FelipeIot/UNIVERSAL_VMS_CONTROL/3DSHAPES/connectors/PinHeader_1x04_P2.54mm_Vertical.step

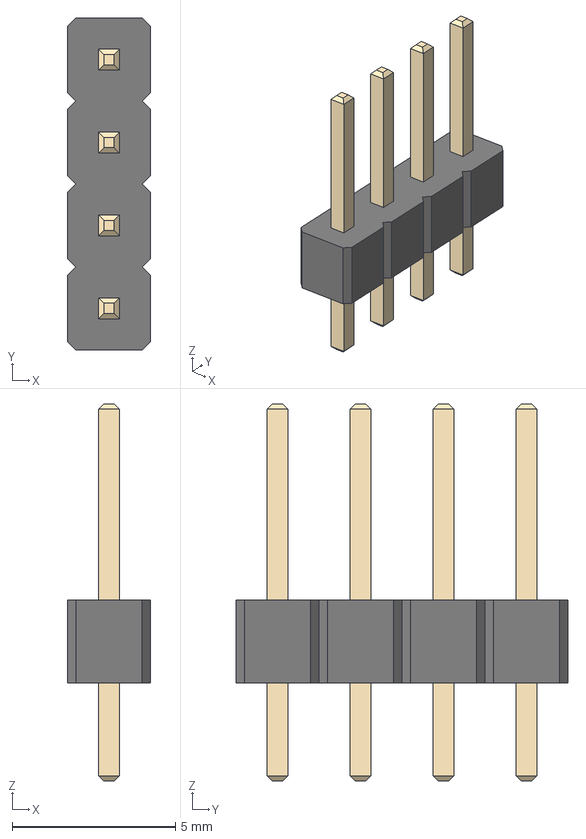
[picture p1: CAD file, 2026-09-01]
3DSHAPES/connectors/PinHeader_1x04_P2.54mm_Vertical.step
2.54 x 10.2 x 11.5 mm
