FelipeIot/UNIVERSAL_VMS_CONTROL/3DSHAPES/ics/SOT-223.step

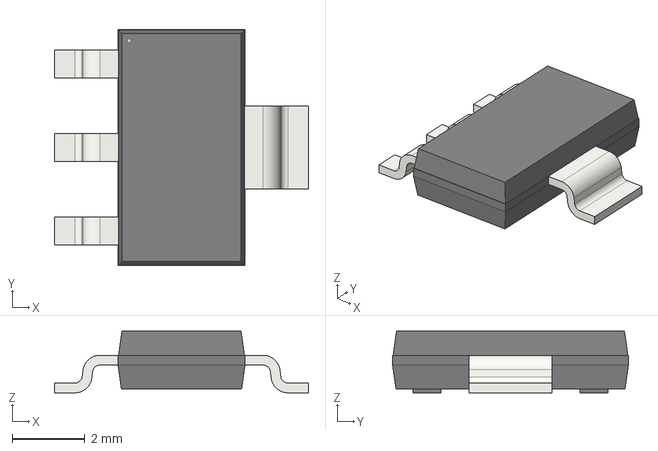
[picture p2: CAD file, 2026-09-01]
3DSHAPES/ics/SOT-223.step
7.00 x 6.50 x 1.70 mm
