FelipeIot/UNIVERSAL_VMS_CONTROL/3DSHAPES/modules/ESP32-S3-WROOM-1.step

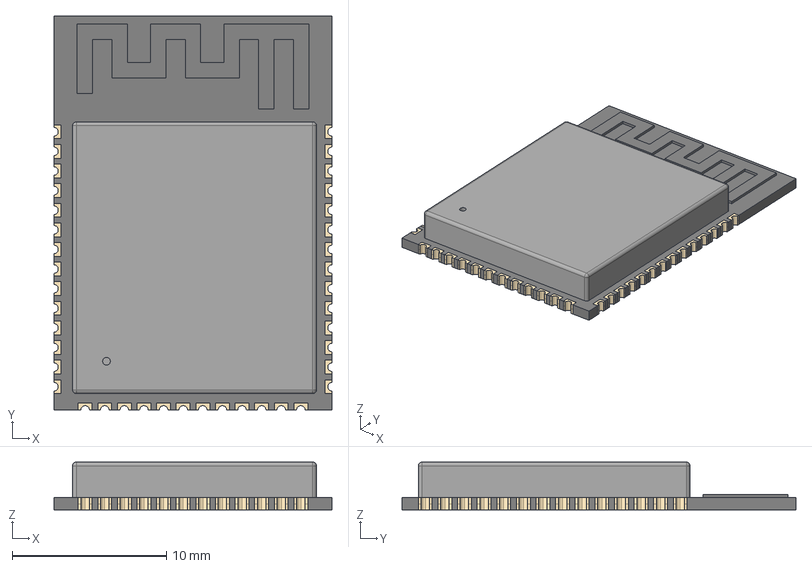
[picture p3: CAD file, 2026-09-01]
3DSHAPES/modules/ESP32-S3-WROOM-1.step
18.0 x 25.5 x 3.10 mm
