FelipeIot/UNIVERSAL_VMS_CONTROL/3DSHAPES/passives/CP_Elec_10x10.5.step

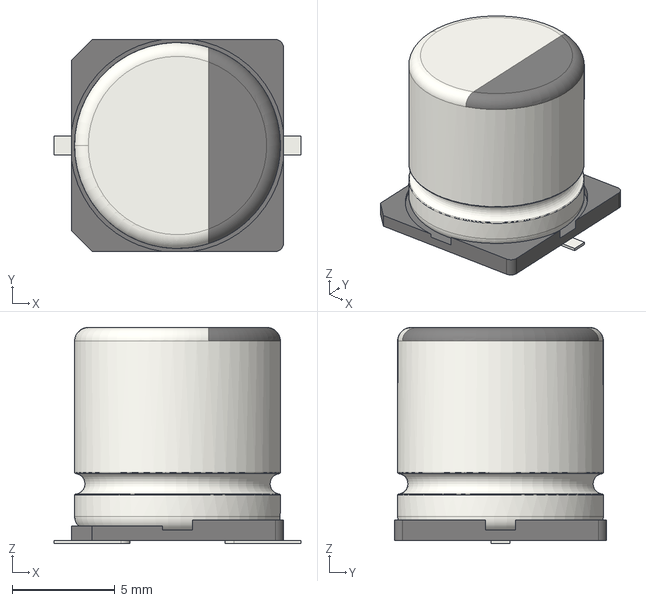
[picture p4: CAD file, 2026-09-01]
3DSHAPES/passives/CP_Elec_10x10.5.step
12.0 x 10.3 x 10.5 mm
