FelipeIot/UNIVERSAL_VMS_CONTROL/3DSHAPES/connectors/U.FL_Hirose_U.FL-R-SMT-1_Vertical.step

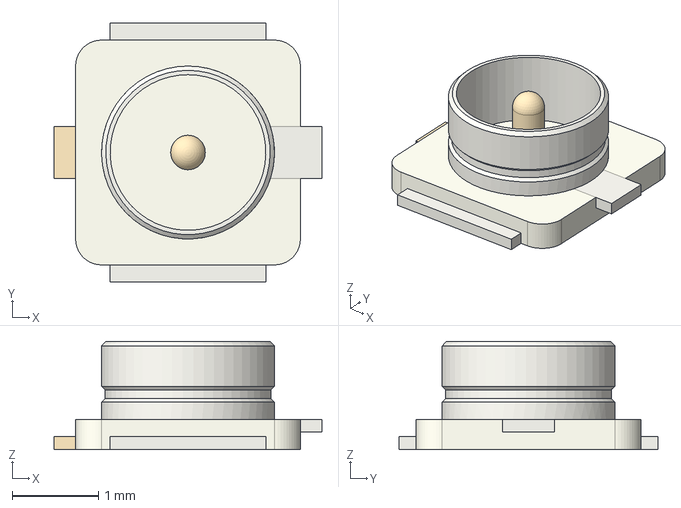
[picture p5: CAD file, 2026-09-01]
3DSHAPES/connectors/U.FL_Hirose_U.FL-R-SMT-1_Vertical.step
3.10 x 3.00 x 1.25 mm
