FelipeIot/UNIVERSAL_VMS_CONTROL/3DSHAPES/ics/SOIC-16_3.9x9.9mm_P1.27mm.step

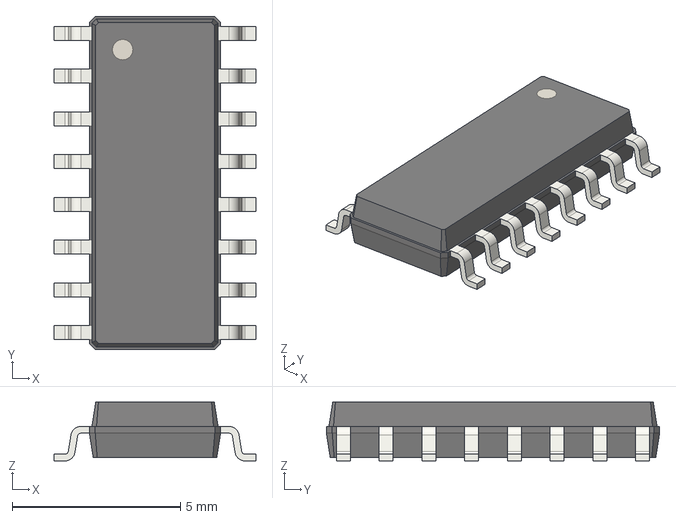
[picture p6: CAD file, 2026-09-01]
3DSHAPES/ics/SOIC-16_3.9x9.9mm_P1.27mm.step
6.00 x 9.90 x 1.75 mm
