FelipeIot/UNIVERSAL_VMS_CONTROL/3DSHAPES/passives/LED_D5.0mm.step

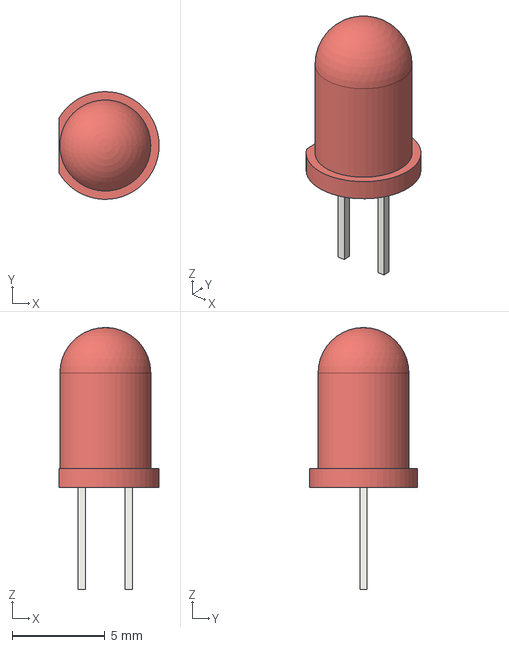
[picture p7: CAD file, 2026-09-01]
3DSHAPES/passives/LED_D5.0mm.step
5.40 x 5.79 x 14.1 mm
