FelipeIot/UNIVERSAL_VMS_CONTROL/3DSHAPES/connectors/USB_C_Receptacle_GCT_USB4085.step

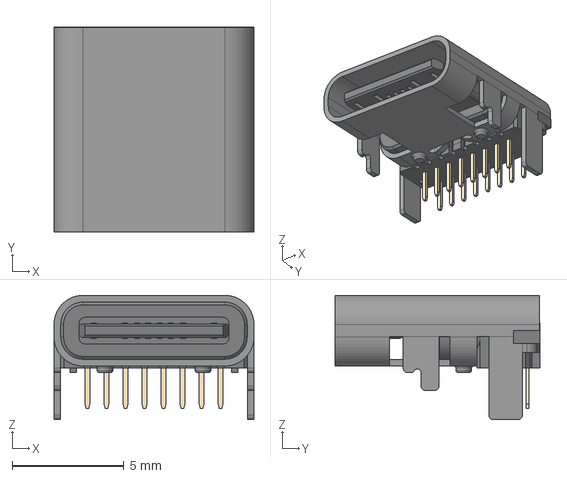
[picture p8: CAD file, 2026-09-01]
3DSHAPES/connectors/USB_C_Receptacle_GCT_USB4085.step
8.94 x 9.17 x 5.56 mm
