FelipeIot/UNIVERSAL_VMS_CONTROL/3DSHAPES/ics/TO-263-5_TabPin3.step

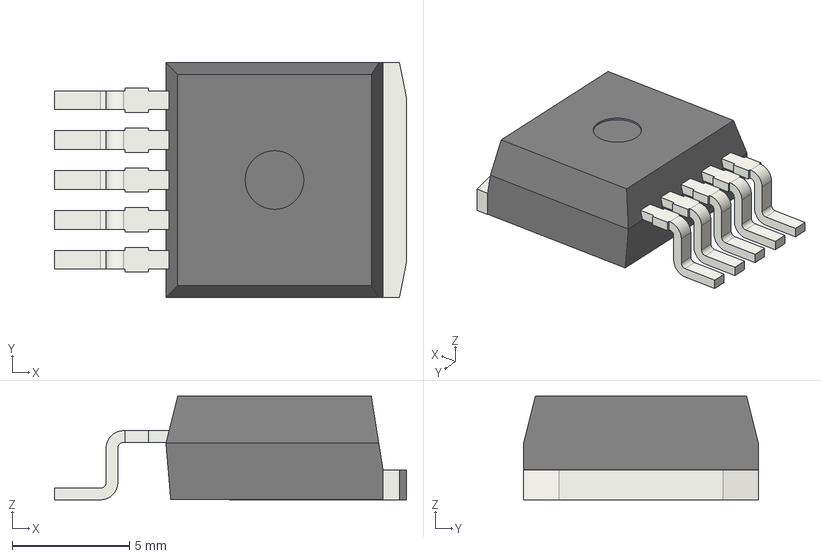
[picture p9: CAD file, 2026-09-01]
3DSHAPES/ics/TO-263-5_TabPin3.step
15.0 x 10.0 x 4.42 mm
a648ce37-9c39-11ed-93f0-dde97e994e83_part
a648ce38-9c39-11ed-93f0-dde97e994e83_part
a648ce39-9c39-11ed-93f0-dde97e994e83_part
