FelipeIot/UNIVERSAL_VMS_CONTROL/3DSHAPES/passives/SW_PUSH_6mm.step

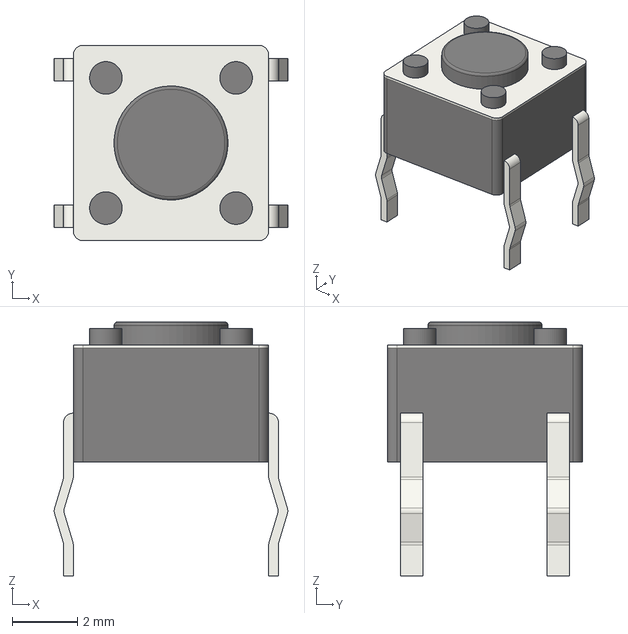
[picture p10: CAD file, 2026-09-01]
3DSHAPES/passives/SW_PUSH_6mm.step
7.17 x 6.00 x 7.80 mm
