FelipeIot/UNIVERSAL_VMS_CONTROL/3DSHAPES/connectors/DSUB-9_Pins_Horizontal_P2.77x2.84mm_EdgePinOffset9.40mm.step

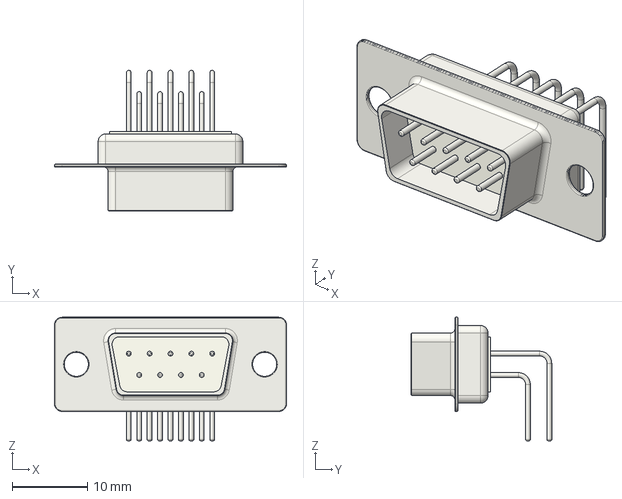
[picture p11: CAD file, 2026-09-01]
3DSHAPES/connectors/DSUB-9_Pins_Horizontal_P2.77x2.84mm_EdgePinOffset9.40mm.step
30.8 x 18.7 x 16.4 mm
