FelipeIot/UNIVERSAL_VMS_CONTROL/3DSHAPES/ics/SO8.STEP

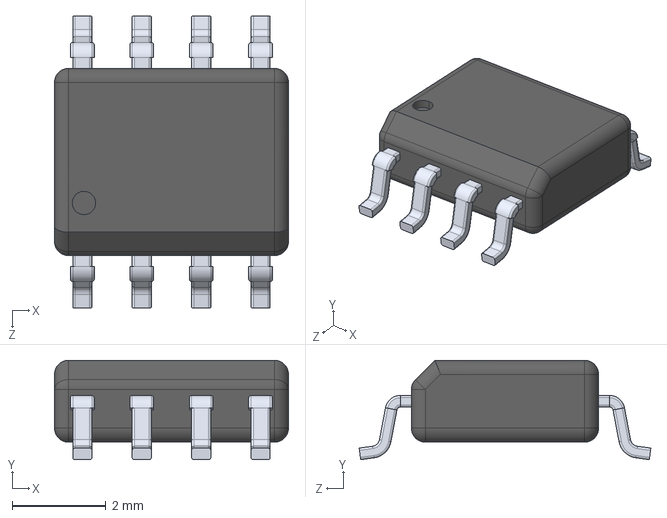
[picture p12: CAD file, 2026-09-01]
3DSHAPES/ics/SO8.STEP
5.00 x 2.12 x 6.23 mm
