FelipeIot/UNIVERSAL_VMS_CONTROL/3DSHAPES/passives/R_1206_3216Metric.step

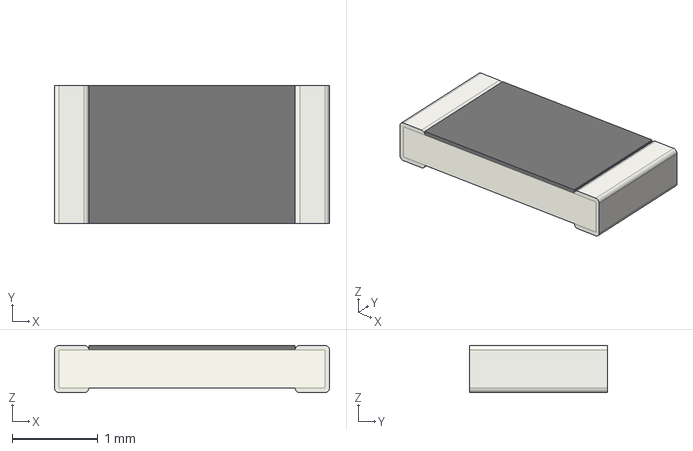
[picture p13: CAD file, 2026-09-01]
3DSHAPES/passives/R_1206_3216Metric.step
3.20 x 1.60 x 0.55 mm
