FelipeIot/UNIVERSAL_VMS_CONTROL/3DSHAPES/connectors/nanoSIM_Hinged_CUI_NSIM-2-C.step

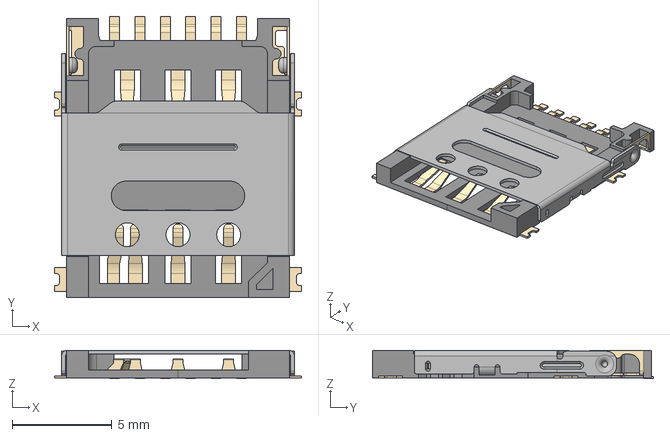
[picture p14: CAD file, 2026-09-01]
3DSHAPES/connectors/nanoSIM_Hinged_CUI_NSIM-2-C.step
12.4 x 14.1 x 1.43 mm
