FelipeIot/UNIVERSAL_VMS_CONTROL/3DSHAPES/ics/SOT-23-6.step

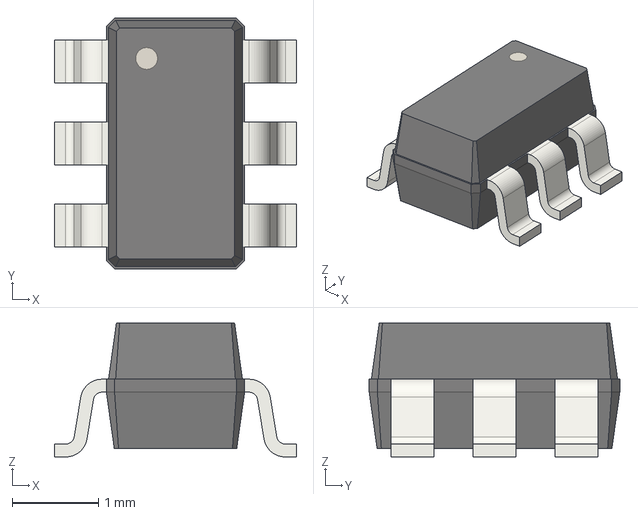
[picture p15: CAD file, 2026-09-01]
3DSHAPES/ics/SOT-23-6.step
2.80 x 2.90 x 1.55 mm
