FelipeIot/UNIVERSAL_VMS_CONTROL/3DSHAPES/passives/D_SMA.step

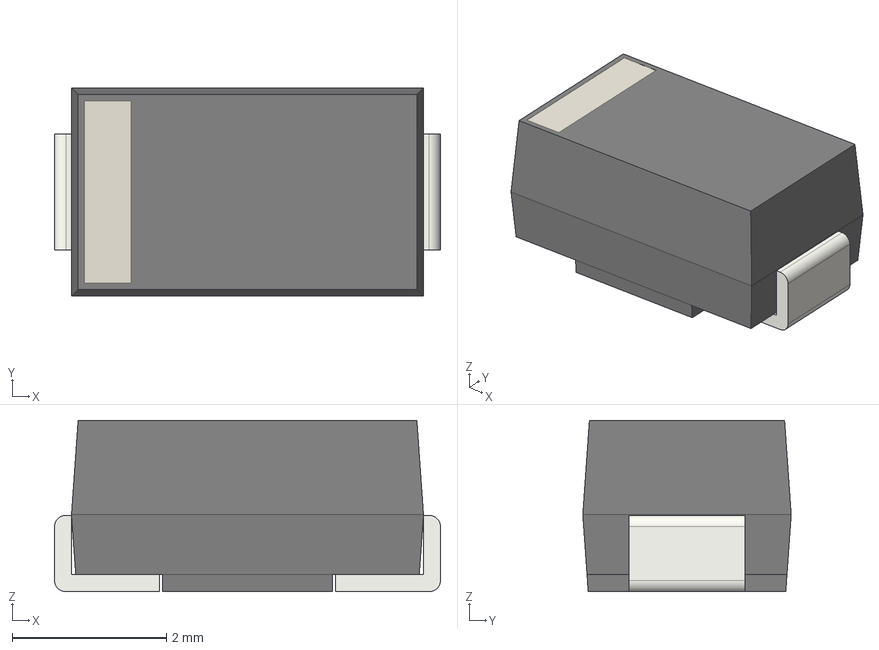
[picture p16: CAD file, 2026-09-01]
3DSHAPES/passives/D_SMA.step
5.00 x 2.70 x 2.22 mm
