FelipeIot/UNIVERSAL_VMS_CONTROL/3DSHAPES/connectors/MOLEX10POS.stp

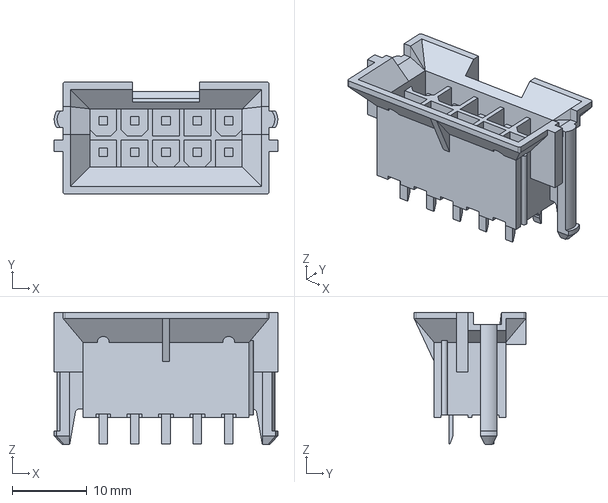
[picture p17: CAD file, 2026-09-01]
3DSHAPES/connectors/MOLEX10POS.stp
30.0 x 15.0 x 17.7 mm
