FelipeIot/UNIVERSAL_VMS_CONTROL/3DSHAPES/ics/TSSOP-24_4.4x7.8mm_P0.65mm.step

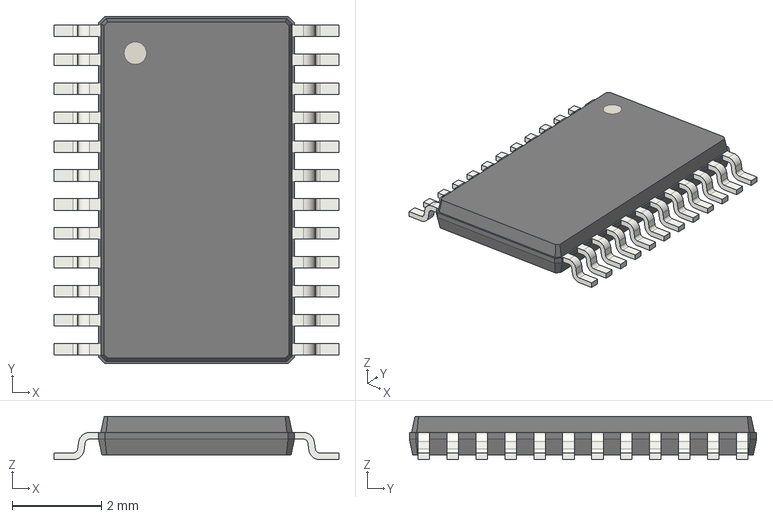
[picture p18: CAD file, 2026-09-01]
3DSHAPES/ics/TSSOP-24_4.4x7.8mm_P0.65mm.step
6.40 x 7.80 x 0.97 mm
