FelipeIot/UNIVERSAL_VMS_CONTROL/3DSHAPES/passives/D_SOD-123F.step

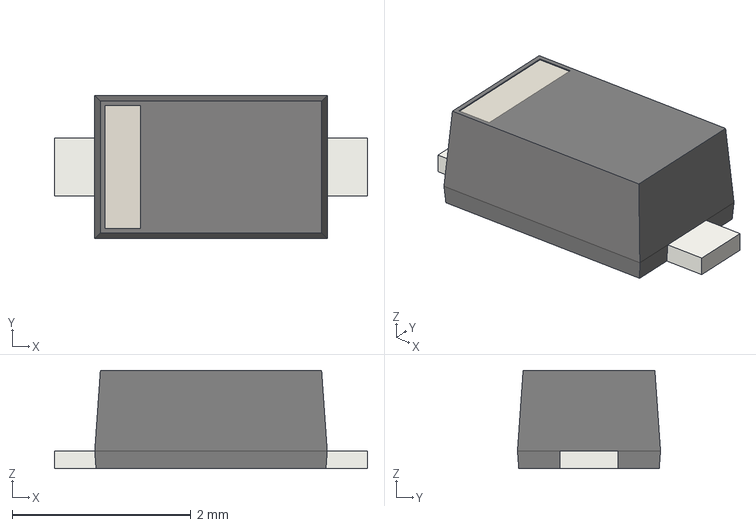
[picture p21: CAD file, 2026-09-01]
3DSHAPES/passives/D_SOD-123F.step
3.50 x 1.60 x 1.10 mm
