FelipeIot/UNIVERSAL_VMS_CONTROL/3DSHAPES/connectors/SMA_Amphenol_132134-11_Vertical.step

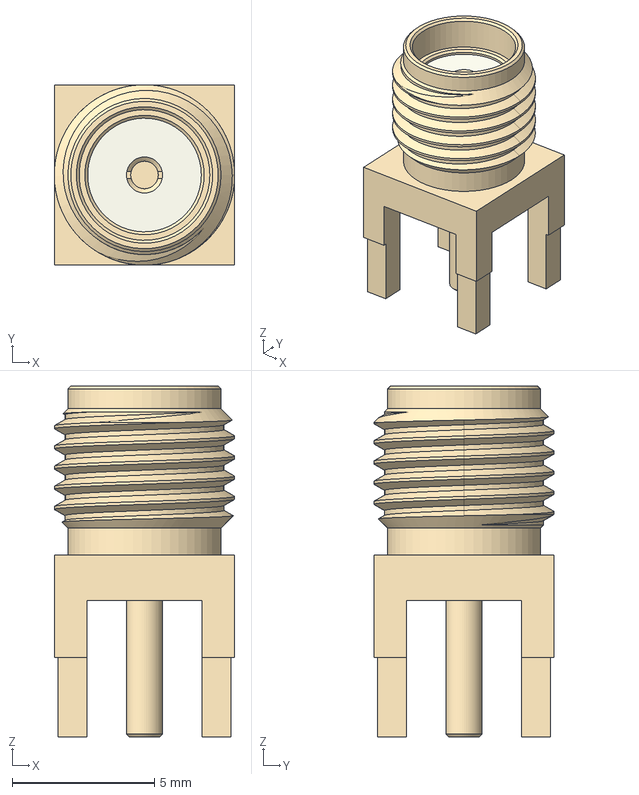
[picture p22: CAD file, 2026-09-01]
3DSHAPES/connectors/SMA_Amphenol_132134-11_Vertical.step
6.35 x 6.35 x 12.4 mm
