FelipeIot/UNIVERSAL_VMS_CONTROL/3DSHAPES/passives/D_SOD-123.step

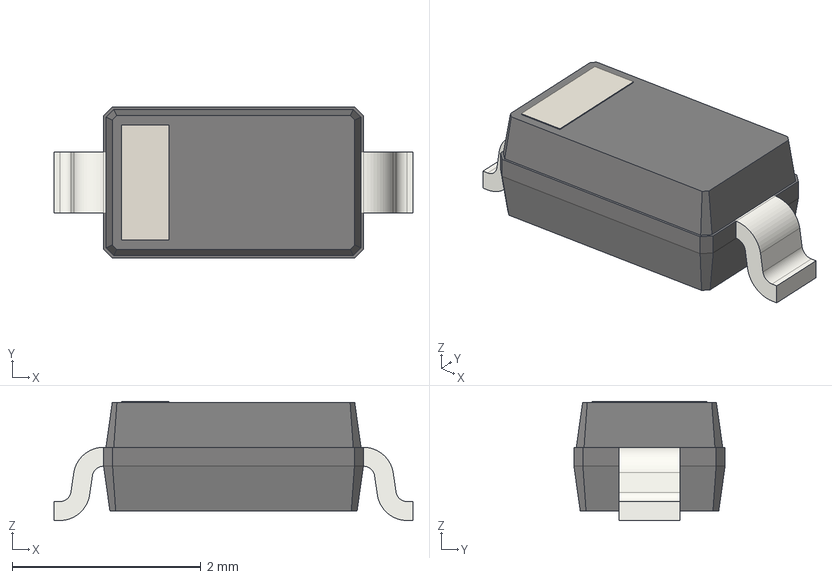
[picture p23: CAD file, 2026-09-01]
3DSHAPES/passives/D_SOD-123.step
3.80 x 1.60 x 1.26 mm
