FelipeIot/UNIVERSAL_VMS_CONTROL/3DSHAPES/connectors/DG302-5.0-02P-12-00AH.STEP

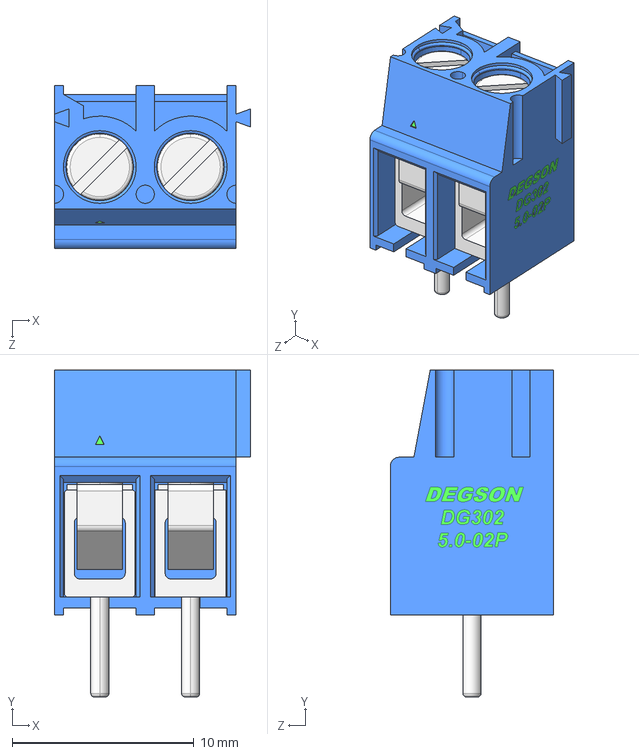
[picture p24: CAD file, 2026-09-01]
3DSHAPES/connectors/DG302-5.0-02P-12-00AH.STEP
10.8 x 18.0 x 9.00 mm
