FelipeIot/UNIVERSAL_VMS_CONTROL/3DSHAPES/passives/CP_Elec_8x10.5.step

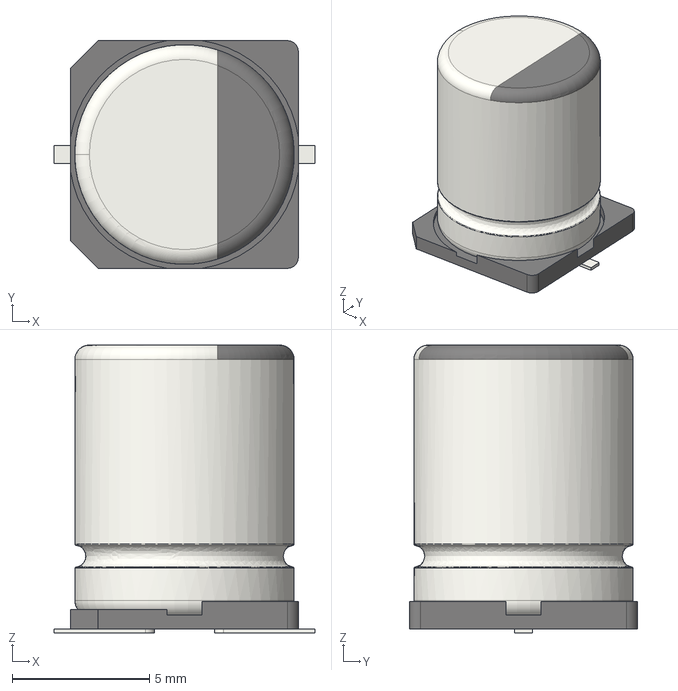
[picture p25: CAD file, 2026-09-01]
3DSHAPES/passives/CP_Elec_8x10.5.step
9.50 x 8.30 x 10.5 mm
