FelipeIot/UNIVERSAL_VMS_CONTROL/3DSHAPES/passives/C_0805_2012Metric.step

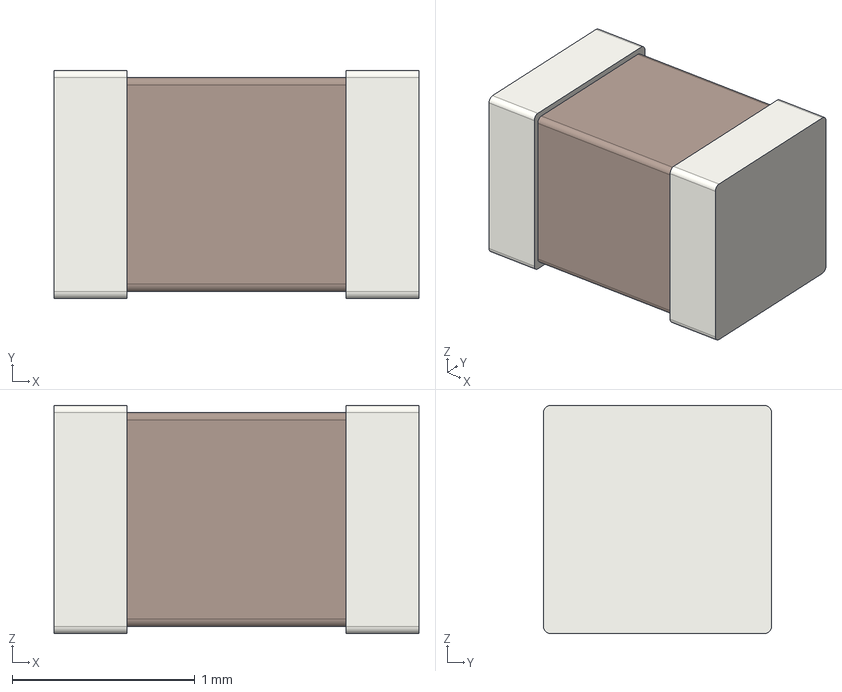
[picture p26: CAD file, 2026-09-01]
3DSHAPES/passives/C_0805_2012Metric.step
2.00 x 1.25 x 1.25 mm
