FelipeIot/UNIVERSAL_VMS_CONTROL/3DSHAPES/passives/D_2114_3652Metric.step

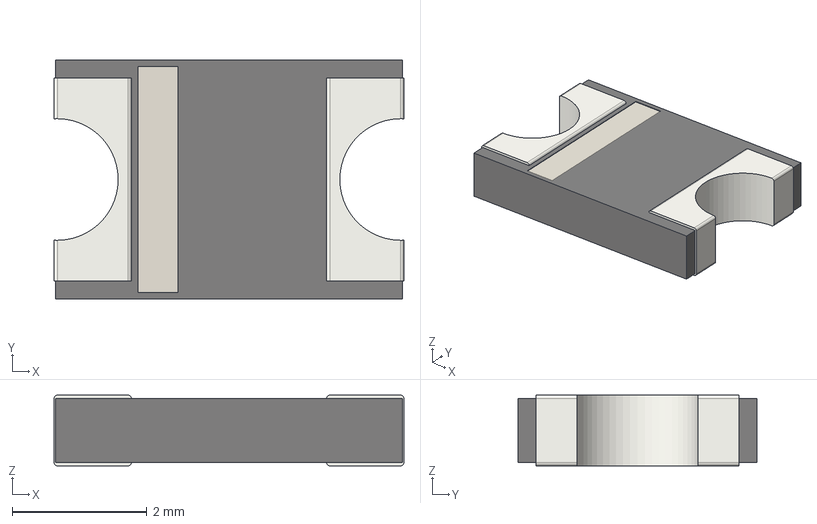
[picture p27: CAD file, 2026-09-01]
3DSHAPES/passives/D_2114_3652Metric.step
5.20 x 3.55 x 1.05 mm
