FelipeIot/UNIVERSAL_VMS_CONTROL/3DSHAPES/passives/L_Bourns_SDR1806.step

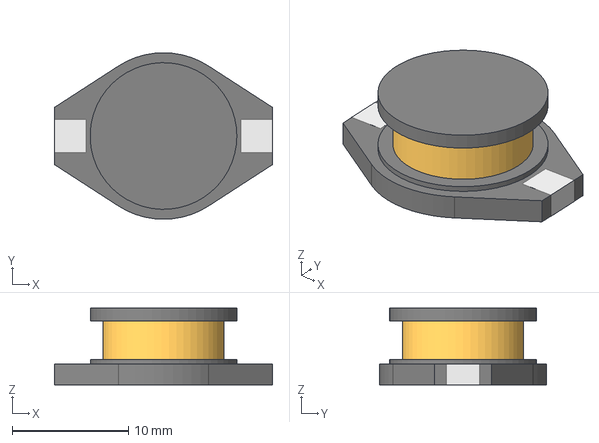
[picture p28: CAD file, 2026-09-01]
3DSHAPES/passives/L_Bourns_SDR1806.step
18.7 x 14.3 x 6.61 mm
