FelipeIot/UNIVERSAL_VMS_CONTROL/(list of files, cad)

Other CAD files:
3DSHAPES/power/0679L5000-05.step
