FelipeIot/UNIVERSAL_VMS_CONTROL/controlcarreta.kicad_pcb

## KiCad design controlcarreta.kicad_pcb (2026-09-02)

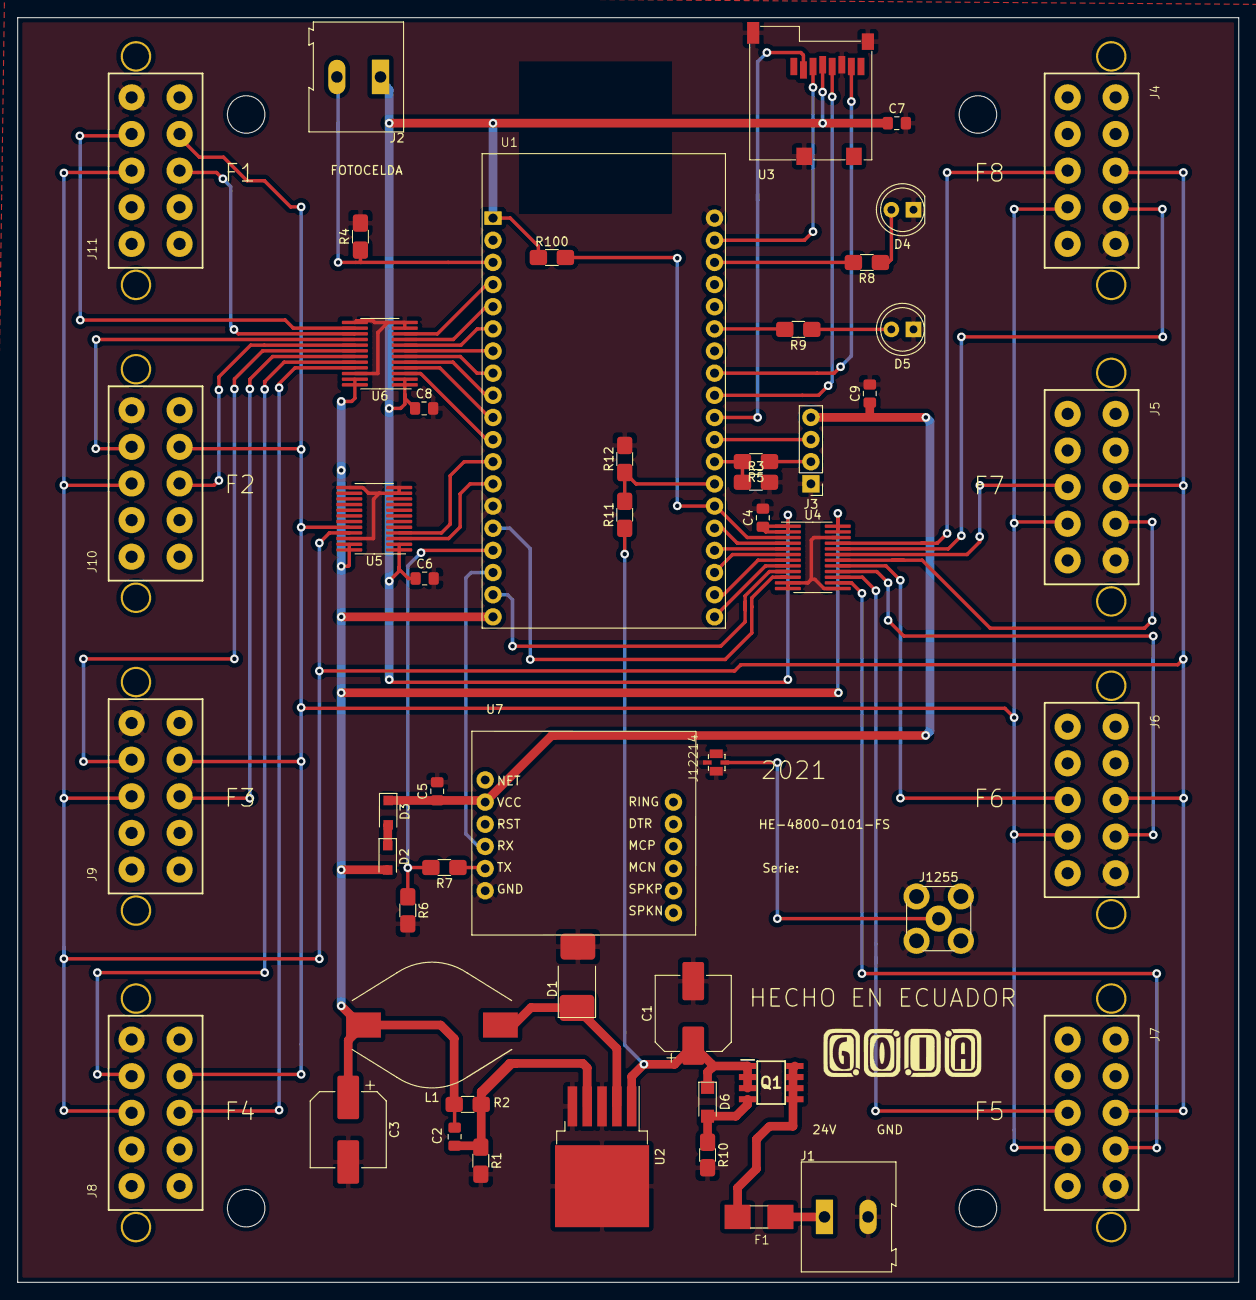
[picture p29: board controlcarreta.kicad_pcb from above]

Board: 2 copper layers, 140.0 x 145.0 mm, 55 parts (0 on the bottom side), 64 nets.

Parts:
C1, C3: CP; CP_Elec_8x10.5
C2: CAP; C_0805_2012Metric_Pad1.18x1.45mm_HandSolder
C4, C5, C6, C7, C8, C9: C; C_0805_2012Metric_Pad1.18x1.45mm_HandSolder
D1: D_Zener; D_2114_3652Metric
D2, D3: 1N4007; D_SOD-123F
D4, D5: LED; LED_D5.0mm
D6: D_Zener; D_SOD-123
F1: 0679L5000-05; FUSC6125X279N
H1, H2, H3, H4: MountingHole; MountingHole_4.3mm_M4
J1, J2: Screw_Terminal_01x02; TerminalBlock_Altech_AK300-2_P5.00mm
J3: Conn_01x04_Male; PinHeader_1x04_P2.54mm_Vertical
J4, J5, J6, J7, J8, J9, J10, J11: MOLEX10POS
J1255: Conn_Coaxial; SMA_Amphenol_132134-16_Vertical
J12214: RSP-122811-02; SAMTEC_RSP-122811-02
L1: INDUCTOR; L_Bourns_SDR1806
Q1: SI4447ADY-T1-GE3; SOIC127P600X175-8N
R1, R12: 1k; R_1206_3216Metric_Pad1.30x1.75mm_HandSolder
R2: 3k; R_1206_3216Metric_Pad1.30x1.75mm_HandSolder
R3, R4, R6: 10k; R_1206_3216Metric_Pad1.30x1.75mm_HandSolder
R5, R7: 1.5k; R_1206_3216Metric_Pad1.30x1.75mm_HandSolder
R8, R9: 330 ohm; R_1206_3216Metric_Pad1.30x1.75mm_HandSolder
R10: 100K; R_1206_3216Metric
R11: 22k; R_1206_3216Metric_Pad1.30x1.75mm_HandSolder
R100: R; R_1206_3216Metric_Pad1.30x1.75mm_HandSolder
U1: ESP32-DEVKITC-32D; MODULE_ESP32-DEVKITC-32D
U2: LM2596S-ADJ; TO-263-5_TabPin3
U3: sdcard; sdcardgoia
U4, U5, U6: 74LVC8T245PW; TSSOP-24_4.4x7.8mm_P0.65mm
U7: sim800l

Connections:
+3V3: C4.1, C6.1, C7.1, C8.1, J2.1, R100.1, U1.1, U3.4, U4.1, U4.2, U5.1, U5.2, U6.1, U6.2
+3V8: C5.1, C9.1, D3.1, J3.4, U7.2
+5V: C2.1, C3.1, D2.2, L1.2, R2.1, U1.19, U4.23, U4.24, U5.23, U5.24, U6.23, U6.24
+24V: C1.1, D6.1, Q1.1, Q1.2, Q1.3, R11.1, U2.1
/BRILLO: U1.13, U5.3
/CL: U1.12, U5.4
/CLOCK: J4.03, J5.03, J6.03, J7.03, J8.03, J9.03, J10.03, J11.03, U5.20
/D1: U1.34, U4.4
/D2: U1.36, U4.6
/D3: U1.38, U4.8
/D4: U1.15, U4.10
/D5: U1.10, U6.4
/D6: U1.8, U6.6
/D7: U1.6, U6.8
/D8: U1.4, U6.10
/DIM: J4.06, J5.06, J6.06, J7.06, J8.06, J9.06, J10.06, J11.06, U5.21
/FOTO: J2.2, R4.1, U1.3
/LE1: R100.2, U1.33, U4.3
/LE2: U1.35, U4.5
/LE3: U1.37, U4.7
/LE4: U1.18, U4.9
/LE5: U1.11, U6.3
/LE6: U1.9, U6.5
/LE7: U1.7, U6.7
/LE8: U1.5, U6.9
/LEN1: J4.05, U4.21
/LEN2: J5.05, U4.19
/LEN3: J6.05, U4.17
/LEN4: J7.05, U4.15
/LEN5: J8.05, U6.21
/LEN6: J9.05, U6.19
/LEN7: J10.05, U6.17
/LEN8: J11.05, U6.15
/MISO: U1.27, U3.7
/MOSI: U1.21, U3.3
/RX_GPS: J3.3, U1.30
/RX_SIM: U1.17, U7.4
/SCK: U1.28, U3.5
/SIN1: J4.04, U4.20
/SIN2: J5.04, U4.18
/SIN3: J6.04, U4.16
/SIN4: J7.04, U4.14
/SIN5: J8.04, U6.20
/SIN6: J9.04, U6.18
/SIN7: J10.04, U6.16
/SIN8: J11.04, U6.14
/SS: U1.29, U3.2
/TX_GPS: R3.1, R5.2, U1.31
/TX_SIM: R6.1, R7.2, U1.16
/VREAD: R11.2, R12.1, U1.32
GND: C1.2, C3.2, C4.2, C5.2, C6.2, C7.2, C8.2, C9.2, D1.2, D4.1, D5.1, J1.2, J3.1, J4.02, J5.02, J6.02, J7.02, J8.02, J9.02, J10.02, J11.02, J1255.2, J1255.3, J12214.2, J12214.3, J12214.4, R1.2, R3.2, R4.2, R6.2, R10.2, R12.2, U1.14, U1.20, U2.3, U2.5, U3.6, U3.9, U4.11, U4.12, U4.13, U4.22, U5.11, U5.12, U5.13, U5.22, U6.11, U6.12, U6.13, U6.22, U7.6
unnamed: C2.2, R1.1, R2.2, U2.4
unnamed: D1.1, L1.1, U2.2
unnamed: D2.1, D3.2
unnamed: D4.2, R8.1
unnamed: D5.2, R9.1
unnamed: D6.2, Q1.4, R10.1
unnamed: F1.1, J1.1
unnamed: F1.2, Q1.5, Q1.6, Q1.7, Q1.8
unnamed: J3.2, R5.1
unnamed: J1255.1, J12214.1
unnamed: R7.1, U7.5
unnamed: R8.2, U1.22
unnamed: R9.2, U1.25
