FelipeIot/UNIVERSAL_VMS_CONTROL/(commit log)

2026-09-01 Initial commit: proyecto Control Carreta IoT (migrado a ESP32-S3)
    Estado del esquematico (controlcarreta.kicad_sch, KiCad 9):
    - MCU: modulo SMD ESP32-S3-WROOM-1-N8 (antes placa ESP32-DevKitC-32D)
    + circuiteria de soporte (LDO 3V3, EN/BOOT, USB-C nativo, ESD).
    - Modem celular: zocalo Mini PCIe (J14, EG25-G / SIM7600G-H) + buck
    dedicado 24V->3V3/3A, porta nano-SIM, u.FL; antena SMA J1255 conservada.
    Sustituye al SIM800L.
    - Puerto RS-232 para equipo externo: MAX3232 (U11) + DE9 (J17) en GPIO43/44.
    - Se elimino el panel de LED nº 8 (J11) para liberar GPIO.
    - Campo Datasheet de los 87 componentes reales con link de DigiKey.
    - ERC: 0 errores.
    Anadido:
    - 3d_models/ modelos 3D de todos los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
    [0679L5000-05.step, CP_Elec_8x10.5.step, C_0805_2012Metric.step, DG302-5.0-02P-12-00AH.STEP, DSUB-9_Pins_Horizontal_P2.77x2.84mm_EdgePinOffset9.40mm.step, D_2114_3652Metric.step, D_SMA.step, D_SOD-123.step]
2026-09-01 J14: zocalo Mini PCIe con footprint/simbolo estandar de KiCad
    - Simbolo: Connector:Bus_PCI_Express_Mini (antes: simbolo propio MINI_PCIE_52,
    inventado).
    - Footprint: Connector_PCBEdge:BUS_PCI_Express_Mini_Full (zocalo Mini PCIe 52p
    real; antes un nombre inventado que no existia).
    - H5 -> Connector_PCBEdge:JAE_MM60-EZH039-Bx_BUS_PCI_Express_Holder (retencion).
    - R27 (0 ohm) nuevo: pin 23 (UART_CTS del modem) -> GND. El pin es tipo
    'output' en el simbolo estandar, atarlo directo a GND daba error ERC.
    - MINI_PCIE_52 eliminado de controlcarreta.kicad_sym.
    - El cableado se mantiene por numero de pin (mapa en ESP32-S3-MIGRATION.md).
    - collect_3d.py: ahora lee los footprints del esquematico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
    [CP_Elec_10x10.5.step, controlcarreta.kicad_sch]
2026-09-01 U4/U5/U6: 74LVC8T245PW -> version AEC-Q100 (grado automocion)
    MPN/Value = 74LVC8T245PW-Q100J (Nexperia). Mismo chip, mismo footprint
    TSSOP-24, drop-in; solo cambia el grado a AEC-Q100 (-40..+125 C), apropiado
    para el uso en vehiculo. Anadidos campos MPN y MANUFACTURER, y Datasheet
    apunta a la pagina de DigiKey del -Q100J.
    Netlist identico (cambio solo de propiedades). ERC 0 errores.
    Claude-Session: https://claude.ai/code/session_011V2GTHvqBgNdus4vsEVVnA
    [controlcarreta.kicad_sch]
2026-09-01 Esquematico: reorganizacion del layout (subsistemas nuevos sin solapes)
    Reconstruye la disposicion de los ~40 componentes anadidos en la migracion
    a ESP32-S3 (buck del modem, zocalo Mini PCIe J14, USB-C, RS-232) con un
    floor plan por zonas. J14 vuelve a caer dentro de la hoja A3.
    - Conectividad identica al commit anterior: el netlist coincide pin a pin,
    solo cambian posiciones.
    - J14 +3V3AUX a un unico riel/simbolo; GND y MP consolidados.
    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
    [controlcarreta.kicad_sch]
2026-09-01 J14: zocalo real JAE MM60-52B1-E1-R650 (en stock) en vez del modulo Quectel
    El campo MPN/Datasheet de J14 apuntaba al modulo Quectel EG25GGB-MINIPCIE,
    que no tiene stock. J14 es el ZOCALO Mini PCIe, no el modulo:
    - MPN -> JAE MM60-52B1-E1-R650 (DigiKey Active, ~28k stock, ~1,65 US$),
    socket 52p 0,8mm con eyectores/latch integrados.
    - Value -> "Mini PCIe Socket 52p". La tarjeta EG25-G/SIM7600G-H se inserta,
    no va en BOM (campo "Modulo" informativo).
    - H5 eliminado: el MM60-E1 ya trae la retencion, no hace falta holder aparte.
    - Footprint sin cambios (BUS_PCI_Express_Mini_Full = socket "with clips").
    - Conectividad y ERC sin cambios (0 errores).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
    [controlcarreta.kicad_sch]
2026-09-01 U11: MAX3232IDR (obsoleto) -> MAX3232EIDR ; limpieza de MPNs sin stock
    - U11: el MAX3232IDR esta "Obsolete and no longer manufactured". Cambiado al
    drop-in MAX3232EIDR (TI, Active, ~55k stock, mismo SOIC-16 y pinout, +-15kV ESD).
    - U9: datasheet apuntaba a un clon Slkormicro; ahora al USBLC6-2SC6 de ST
    (Active, ~294k stock). Mismo MPN/footprint.
    - J15: URL actualizada al listado vigente (CUI -> Same Sky), parte NSIM-2-C Active.
    - Verificado el resto de piezas nuevas: LM2596S-ADJ/NOPB, NCP1117ST33T3G,
    USB4085-GF-A, JAE MM60-52B1-E1-R650 -> todas Active y con stock.
    - Sin cambios de conectividad ni de ERC (0 errores).
    Claude-Sessio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
    [controlcarreta.kicad_sch]
2026-09-02 home parcial ordered
    [0679L5000-05.step, CP_Elec_10x10.5.step, CP_Elec_8x10.5.step, C_0805_2012Metric.step, DG302-5.0-02P-12-00AH.STEP, DSUB-9_Pins_Horizontal_P2.77x2.84mm_EdgePinOffset9.40mm.step, D_2114_3652Metric.step, D_SMA.step]
2026-09-02 WIP: J18/Q2/Q3/R30/R31 + reguardado KiCad de todas las hojas
    [controlcarreta.kicad_sch, drivers.kicad_sch, ldo_3v3.kicad_sch, modem.kicad_sch, psu_5v.kicad_sch, psu_modem.kicad_sch, rs232.kicad_sch, sdcard.kicad_sch]
2026-09-02 modem: DTR (J14 pin 31) fuera de GND -> GPIO IO3 (net MODEM_DTR)
    El EG25-G/SIM7600 no puede entrar en sleep con DTR a masa (idle ~20 mA
    en vez de ~4 mA). Se suelta el pin 31 de GND y se lleva a U1 IO3
    (GPIO libre, antes NO_CONNECT) via nueva senal jerarquica MODEM_DTR:
    - modem.kicad_sch: #PWR0551 (GND) -> hierarchical_label MODEM_DTR
    - controlcarreta.kicad_sch: pin de hoja MODEM_DTR + label en U1.15 (IO3),
    se elimina el no_connect de IO3
    ERC sin cambios (370 warnings, 0 errores). Panel LED 7 se conserva:
    habia 3 GPIO libres (IO3/IO45/IO46), no hacia falta sacrificarlo.
    Claude-Session: https://claude.ai/code/session_01T7LXaJdHR17h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
    [controlcarreta.kicad_sch, modem.kicad_sch]
2026-09-02 modem: 2a via de antena ANT_GNSS (J19 u.FL + J20 SMA) para GPS
    El EG25-G / SIM7600 llevan receptor GNSS integrado pero necesitan
    antena propia; el esquematico solo tenia ANT_MAIN. Se anade una 2a via
    RF identica en topologia a ANT_MAIN:
    - modem.kicad_sch: J19 (u.FL Hirose) -> hierarchical_label ANT_GNSS,
    blindaje a GND (#PWR0563). Pigtail u.FL-u.FL a la toma GNSS de la
    tarjeta Mini-PCIe.
    - controlcarreta.kicad_sch: pin de hoja ANT_GNSS + J20 (SMA Amphenol)
    en la net ANT_GNSS, blindaje a GND (#PWR0564). Caja de la hoja MODEM
    ampliada (12.7 -> 17.78 mm) para alojar los 2 pines nuevos.
    - Poblar J19 O J20 (no ambos). Antena GNSS pasiva, vista al cielo,
    >=3 cm de ANT_MAIN.
    ERC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
    [controlcarreta.kicad_sch, modem.kicad_sch]
2026-09-04 friday changes
    [controlcarreta.kicad_sch, drivers.kicad_sch, ldo_3v3.kicad_sch, modem.kicad_sch, psu_5v.kicad_sch, psu_modem.kicad_sch, rs232.kicad_sch, sdcard.kicad_sch]
2026-09-08 schematic updated
    [controlcarreta.kicad_sch, drivers.kicad_sch, ldo_3v3.kicad_sch, modem.kicad_sch, psu_5v.kicad_sch, psu_modem.kicad_sch, rs232.kicad_sch, sdcard.kicad_sch]
2026-09-08 removed gps headear
    [controlcarreta.kicad_sch, ldo_3v3.kicad_sch]
2026-09-08 prettier schematic
    [controlcarreta.kicad_sch, mechanical.kicad_sch, sdcard.kicad_sch]
2026-09-09 2 power source
    [controlcarreta.kicad_sch, drivers.kicad_sch, ldo_3v3.kicad_sch, psu_5v.kicad_sch, psu_modem.kicad_sch, sdcard.kicad_sch]
2026-09-29 last changes in work
    [controlcarreta.kicad_sch, drivers.kicad_sch, ldo_3v3.kicad_sch, modem.kicad_sch, psu_5v.kicad_sch, psu_modem.kicad_sch, sdcard.kicad_sch, usb.kicad_sch]
